AdrianSPratama/SSCS-Chipaton-2025_ChipiChapa/README.md

# SSCS-Chipaton-2025_ChipiChapa
This is ChipiChapa team github repo

## **ChipiChapa Team Project Brief**
Extend OSU's gf180mcu 3v3 standard cell library. Our team makes 4 AOI and OAI combinational gates, that is AOI211, AOI221, OAI211, and OAI221. All of the standard cell we make have 9 tracks and drive strength X1.

## **ChipiChapa Team Members**
1. Rafi Ihsan Alfathin (Leader)
2. Adrian Sami Pratama
3. Muhammad Nabil Raihan
4. Saputra Yudika Marpaung

## **Proposal Slide Link**
https://github.com/AdrianSPratama/SSCS-Chipaton-2025_ChipiChapa/blob/main/proposal/Proposal%20ChipiChapa.pdf

## **Process Tracker Link**
https://docs.google.com/spreadsheets/d/1PtmuyiHweRWKpOBbN-9DdKNZ7erSgrVJdXXUhSANtq4/edit?usp=sharing

## **Schematic/Simulation Review Slide Link**
https://github.com/AdrianSPratama/SSCS-Chipaton-2025_ChipiChapa/blob/main/docs/Schematic%20%26%20Simulation%20Review_ChipiChapa.pdf

## **Pin Out & Estimated Size Slide Link**
https://github.com/AdrianSPratama/SSCS-Chipaton-2025_ChipiChapa/blob/main/docs/Pin%20Out%20%26%20Estimated%20Size_ChipiChapa.pdf

## **ChipiChapa Github Repo**
https://github.com/AdrianSPratama/SSCS-Chipaton-2025_ChipiChapa

## **ChipiChapa Closing Slide**
https://drive.google.com/file/d/1TsjNp-oyjTHYDurA27sHm9y-M0dA2QlG/view?usp=sharing
