AdrianSPratama/SSCS-Chipaton-2025_ChipiChapa/docs/Schematic & Simulation Review_ChipiChapa.pdf

# Schematic/Pre Layout Simulation Review

# ChipiChapa Team

# ChipiChapa Overview

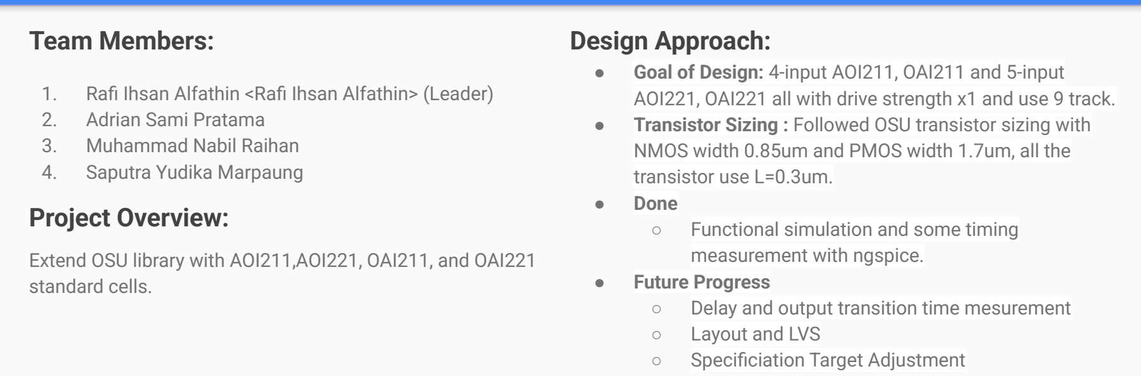
[picture p1: figure]
2. Adrian Sami Pratama 3. Muhammad Nabil Raihan 4. Saputra Yudika Marpaung; Team Members:; Project Overview:; standard cells.; Design Approach:; transistor use L=0.3um. ● Done ○ Functional simulation and some timing measurement with ngspice. ● Future Progress; ○ Layout and LVS ○ Specificiation Target Adjustment

### 1. Rafi Ihsan Alfathin <Rafi Ihsan Alfathin> (Leader)

### Extend OSU library with AOI211,AOI221, OAI211, and OAI221

### - Goal of Design: 4-input AOI211, OAI211 and 5-input

AOI221, OAI221 all with drive strength x1 and use 9 track.

### - Transistor Sizing : Followed OSU transistor sizing with NMOS width 0.85um and PMOS width 1.7um, all the

### - Delay and output transition time mesurement

# Schematic & Functional Simulation

## Schematic

## Symbol

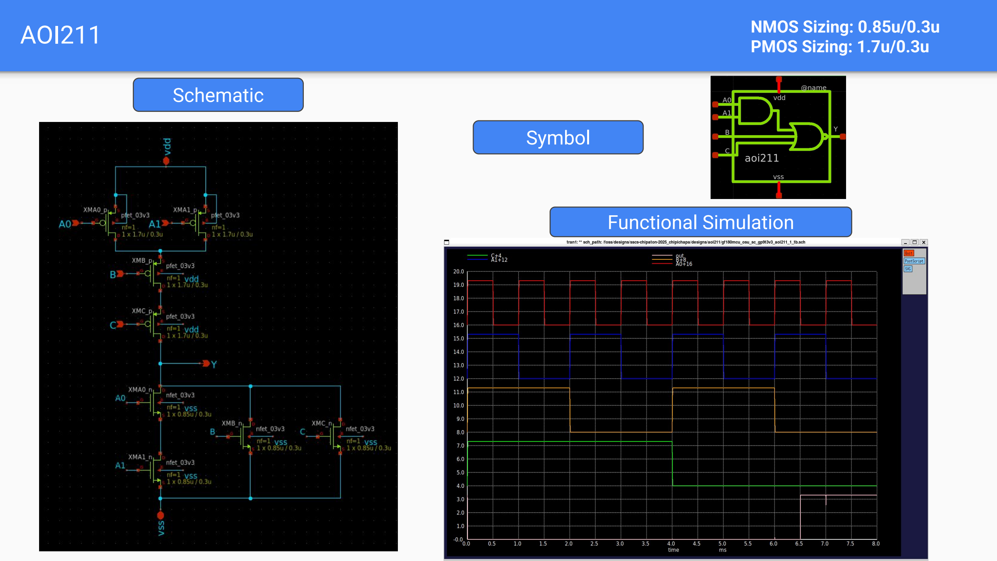
[picture p2: page 4]

AOI211 | NMOS Sizing: 0.85u/0.3u PMOS Sizing: 1.7u/0.3u

## Functional Simulation

## Schematic

## Symbol

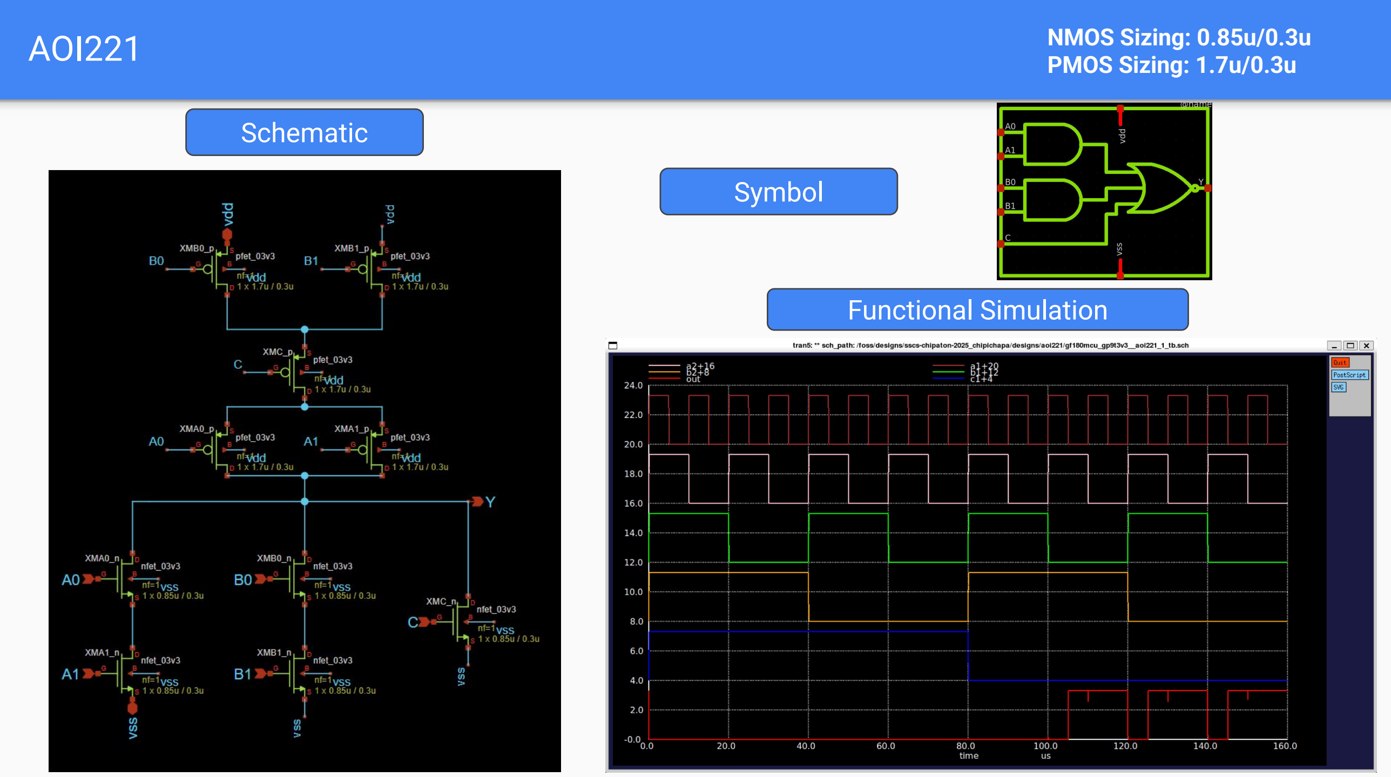
[picture p3: page 5]

AOI221 | NMOS Sizing: 0.85u/0.3u PMOS Sizing: 1.7u/0.3u

## Functional Simulation

## Schematic

## Symbol

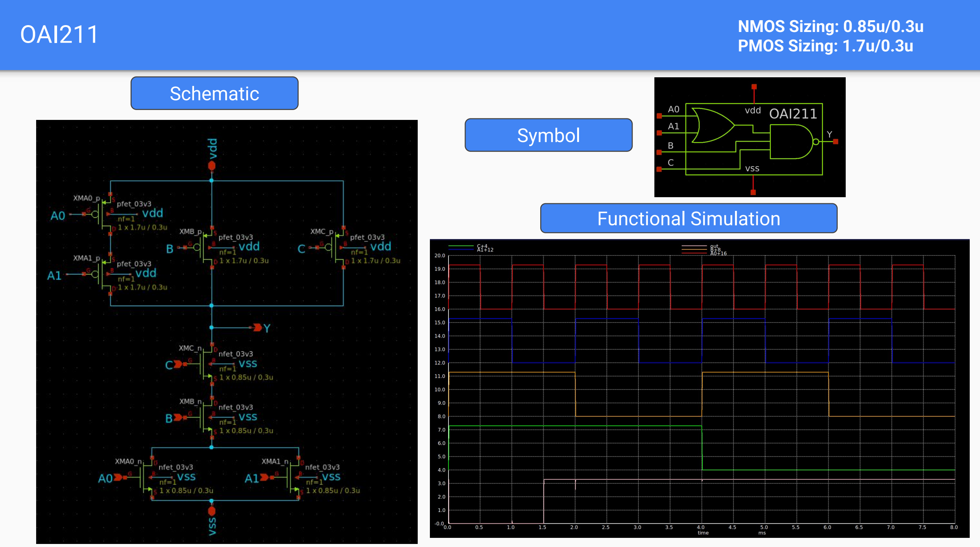
[picture p4: page 6]

OAI211 | NMOS Sizing: 0.85u/0.3u PMOS Sizing: 1.7u/0.3u

## Functional Simulation

## Schematic

## Symbol

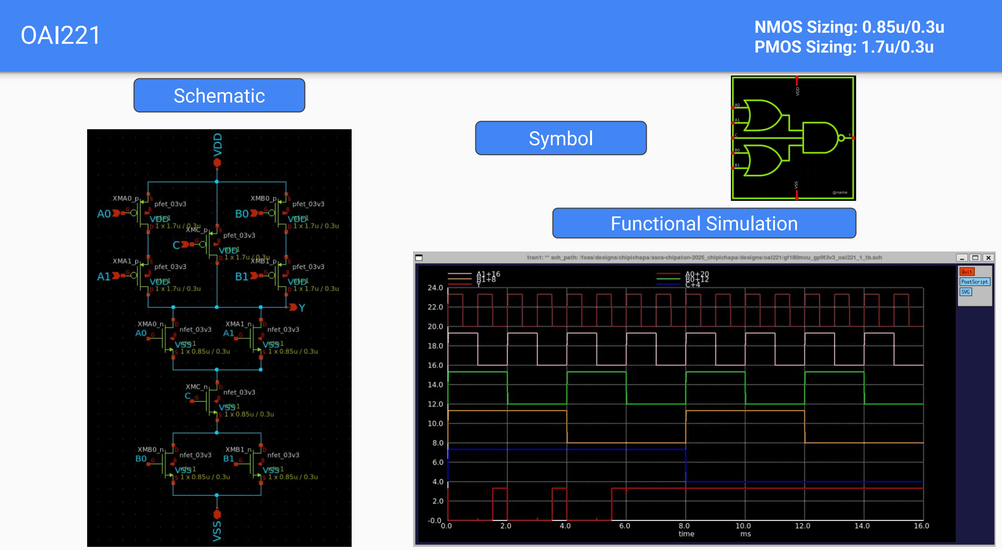
[picture p5: page 7]

OAI221 | NMOS Sizing: 0.85u/0.3u PMOS Sizing: 1.7u/0.3u

## Functional Simulation

# Timing Characterization

# Slews and Load Variations

Slews | 0.0778447 | 0.205581 | 0.542922 | 1.43381 | 3.78657 | 10
Loads | 0.00103698 | 0.00390104 | 0.0146754 | 0.0552075 | 0.207686 | 0.781296

# Note : Only values that correspond to min. slew time and min. output load are

shown in this presentation.

## For AOI211 and AOI221 (followed OSU’s liberty files slew rate and output load for AOI21)

## For OAI211 and OAI221 (followed OSU’s liberty files slew rate and output load for OAI21)

Slews | 0.0778447 | 0.205581 | 0.542922 | 1.43381 | 3.78657 | 10
Loads | 0.00103698 | 0.00389877 | 0.0146583 | 0.0551109 | 0.207201 | 0.779018

# AOI211

Input Pin | Output | Tin (ns) | Out Load (pf) | Delay (ns) | Tout (ns)
A0 (HL) | Y (LH) | 0.0778447 | 0.00103698 | 0.162159 | 0.124471
A0 (LH) | Y (HL) | 0.0778447 | 0.00103698 | 0.091997 | 0.113079
A1 (HL) | Y (LH) | 0.0778447 | 0.00103698 | 0.195498 | 0.161144
A1 (LH) | Y (HL) | 0.0778447 | 0.00103698 | 0.101589 | 0.113557
B (HL) | Y (LH) | 0.0778447 | 0.00103698 | 0.163017 | 0.160679
B (LH) | Y (HL) | 0.0778447 | 0.00103698 | 0.053543 | 0.046408
C (HL) | Y (LH) | 0.0778447 | 0.00103698 | 0.107839 | 0.153007
C (LH) | Y (HL) | 0.0778447 | 0.00103698 | 0.040542 | 0.030509
Pin | Type | Capacitance (pf)
A0 | input | 0.003278
A1 | input | 0.003335
B | input | 0.003200
C | input | 0.003281
Timing Characteristic (Worst Case) | Pin Capacitance

# AOI221

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

Logic
Combination

Leakage Power (nW)

!C!B1!B0!A1!A0 | 0.0233794
!C!B1!B0!A1A0 | 0.0497661
!C!B1!B0A1!A0 | 0.0338073
!C!B1!B0A1A0 | 0.0338025
!C!B1B0!A1!A0 | 0.0233706
!C!B1B0!A1A0 | 0.0497602
!C!B1B0A1!A0 | 0.0338014
!C!B1B0A1A0 | 0.0337944

Average Leakage
Power | 0.0436594

# Thanks!

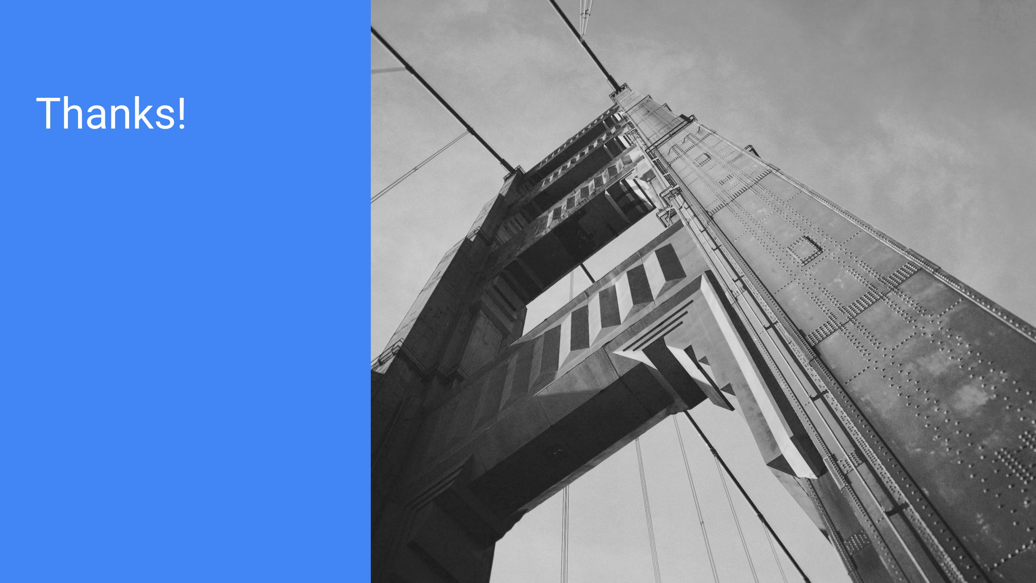
[picture p6: page 19]
