AdrianSPratama/SSCS-Chipaton-2025_ChipiChapa/proposal/Proposal ChipiChapa.pdf

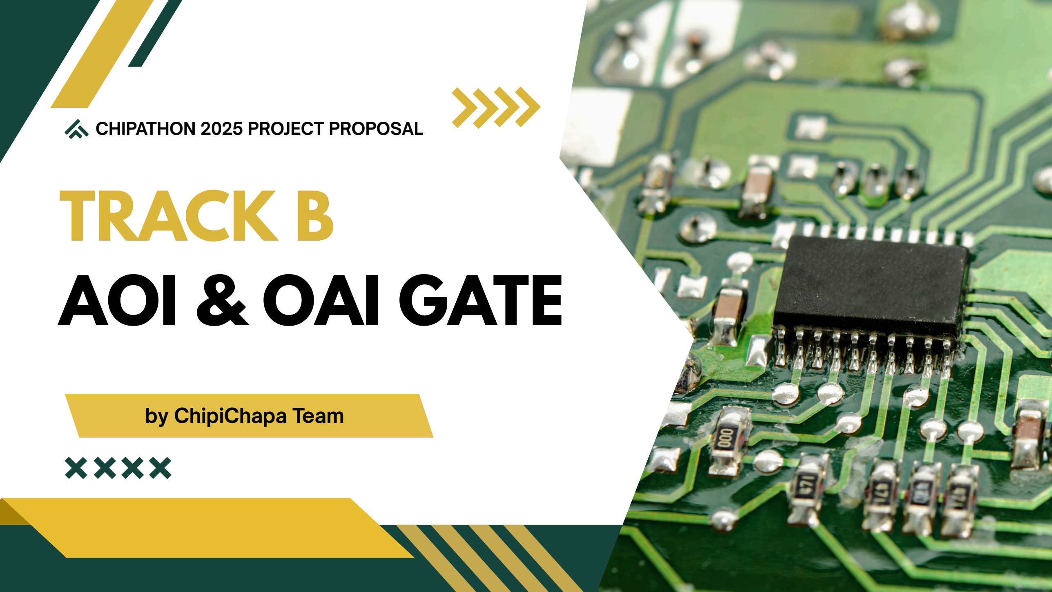
[picture p7: figure]
TRACK B AOI & OAI GATE; by ChipiChapa Team; CHIPATHON 2025 PROJECT PROPOSAL

# Background

In this chipaton, our team will make 4 standard cells library, that is AOI211, OAI211, AOI221, and OAI221.

# We make these AOI dan OAI cells for fundamental cell of further macro cells

like arithmatic cells and multiplexer.

# For the reference of performaces (delay, power, etc), we use performance from standard cells gf180mcu with 5v VDD, and make some goal prediction from those 5v standard cells (tweaking the delay time, power, etc from 5v

and predict how it works for 3v3).

# Functionality

# AOI211

In this chipaton, our team will make 4 standard cells library, that is AOI211, OAI211, AOI31, and OAI221.

# AOI211 is a standard cells with 4 input that has boolean expression:

# Y = !((A1 & A2) | B1 | C1)

# AOI221

# AOI221 is a standard cells with 5 input that has boolean expression:

# Y = !((A1 & A2) | (B1 & B2) | C1)

# OAI211

# OAI211 is a standard cells with 4 input that has boolean expression:

# Y = !((A1 | A2) & B1 & C1))

# OAI221

# OAI221 is a standard cells with 5 input that has boolean expression:

# Y = !((A1 | A2) & (B1 | B2) & C1)

LIBRARY | gf180mcu_osu_sc_9t3v3

CELLS

1. AOI 211 :
gf180mcu_osu_sc_gp9t3v3__aoi211_1 (https://github.com/stineje/globalfoundries-pdk-libs-gf180mcu_osu_sc/blob/main/gf180mcu_osu_sc_gp9t3v3/cells/aoi22/gf180mcu_osu_sc_gp9t3v3__aoi22_1.gds)
2. OAI211:
gf180mcu_osu_sc_gp9t3v3__oai211_1 (https://github.com/stineje/globalfoundries-pdk-libs-gf180mcu_osu_sc/blob/main/gf180mcu_osu_sc_gp9t3v3/cells/aoi22/gf180mcu_osu_sc_gp9t3v3__aoi22_1.gds) 3.AOI221:
gf180mcu_osu_sc_gp9t3v3__aoi221_1 (https://github.com/stineje/globalfoundries-pdk-libs-gf180mcu_osu_sc/blob/main/gf180mcu_osu_sc_gp9t3v3/cells/aoi22/gf180mcu_osu_sc_gp9t3v3__aoi22_1.gds) 4.OAI221:
gf180mcu_osu_sc_gp9t3v3__oai221_1 (https://github.com/stineje/globalfoundries-pdk-libs-gf180mcu_osu_sc/blob/main/gf180mcu_osu_sc_gp9t3v3/cells/aoi22/gf180mcu_osu_sc_gp9t3v3__aoi22_1.gds)
DRIVE STRENGTH | 1X
TRACK | 9 Track
VDD | 3.3V

# General Format & Specification

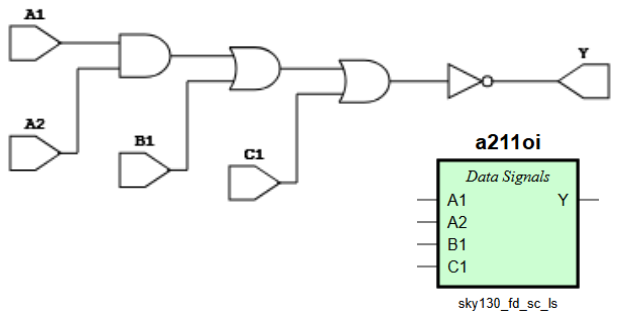
[picture p8: figure]

Specification | Target
Input Capacitance | <0.01 pF
Delay | <0.40 ns
Output Load | 0.001 pF

# Gate Level

# Block Diagram & Schematic - AOI211

Specification | Target

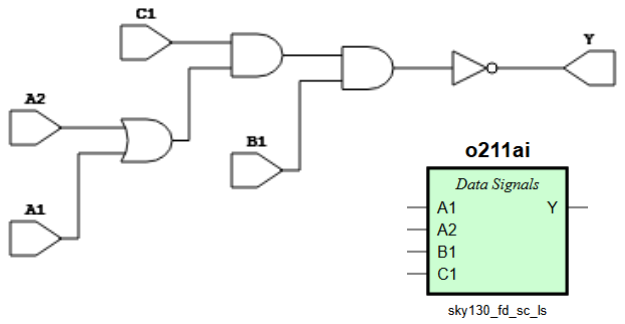
[picture p9: figure]

Input Capacitance | <0.01 pF
Delay | <0.40 ns
Output Load | 0.001 pF

# Gate Level

# Block Diagram & Schematic - OAI211

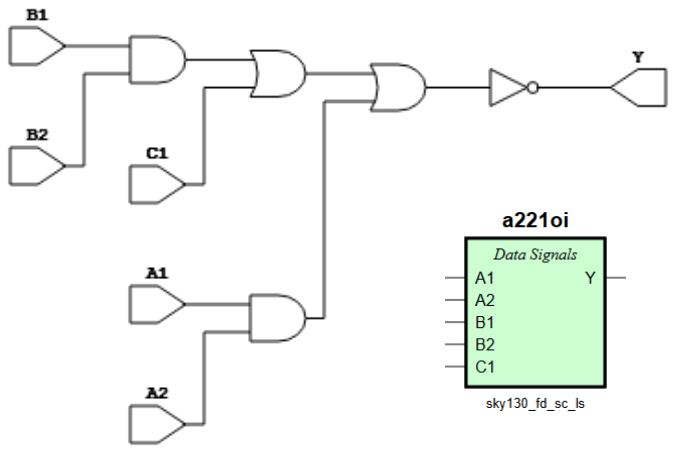
[picture p10: figure]

Specification | Target
Input Capacitance | <0.01 pF
Delay | <0.90ns
Output Load | 0.001 pF

# Gate Level

# Block Diagram & Schematic - AOI221

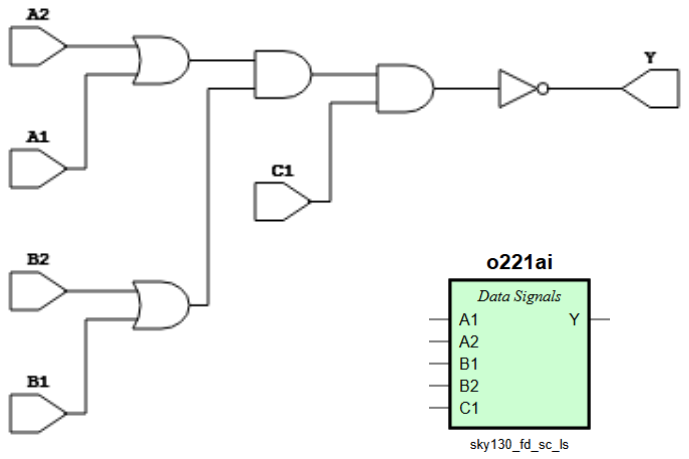
[picture p11: figure]

Specification | Target
Input Capacitance | <0.01 pF
Delay | <0.90ns
Output Load | 0.001 pF

# Block Diagram & Schematic - OAI221

# Gate Level

Member Name | Rafi Ihsan Alfathin | Saputra Yudika Marpaung | Adrian Sami Pratama | Muhammad Nabil Raihan
Block will be working on | AOI211 | OAI211 | AOI221 | OAI221

Task Detail

1.Design schematic
with XSchem
2.Simulation with
ngspice
3.Layouting, DRC, and
LVS with
Klayout/Magic
4.Generate parasitic
RC with Magic
5.Characterizing the
cell with
Charlib/Libretto

1.Design schematic
with XSchem
2.Simulation with
ngspice
3.Layouting, DRC, and
LVS with
Klayout/Magic
4.Generate parasitic
RC with Magic
5.Characterizing the
cell with
Charlib/Libretto

1.Design schematic
with XSchem
2.Simulation with
ngspice
3.Layouting, DRC, and
LVS with
Klayout/Magic
4.Generate parasitic
RC with Magic
5.Characterizing the
cell with
Charlib/Libretto

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

# Task Distribution

# Our Team Task

| Chipathon’s Plan (Week)
Team Formation and Project Planning | Design and Simulation | Layout and Verification
28 | 29 | 30 | 31 | 32 | 33 | 34 | 35 | 36 | 37 | 38 | 39 | 40

Design schematic with XSchem

Simulation with ngspice

Layouting, DRC, and LVS with Klayout/Magic

Generate parasitic RC with Magic

Characterizing the cell with Charlib/Libretto, revision, and finalization

# Project Timeline

# THANK YOU

### link to our github : ChipiChapa Github Repo Link: https://github.com/AdrianSPratama/SSCS-Chipaton-2025_ChipiChapa?tab=readme-ov-file

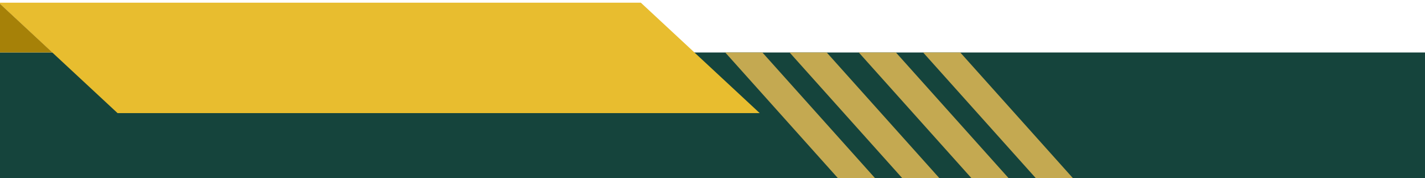
[picture p12: figure]
