AdrianSPratama/SSCS-Chipaton-2025_ChipiChapa/designs/aoi221/gf180mcu_gp9t3v3__aoi221_1_schematic.png

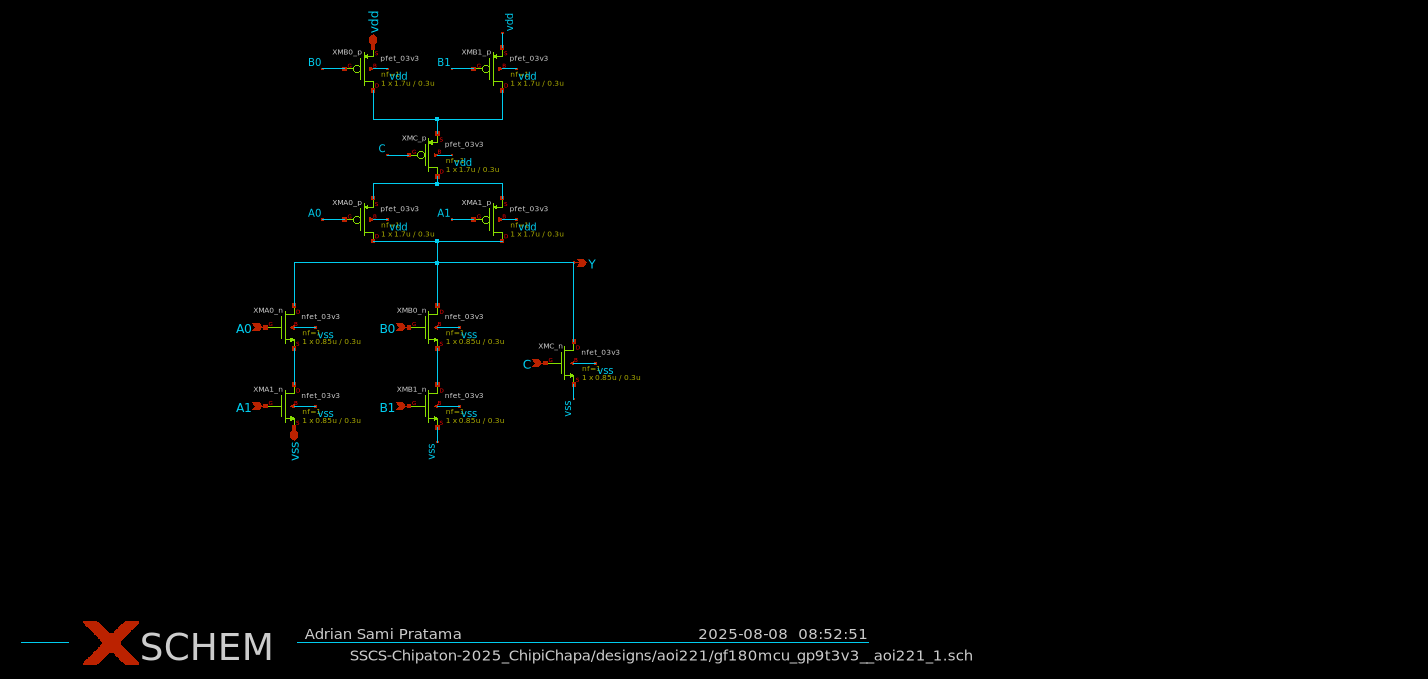
designs/aoi221/gf180mcu_gp9t3v3__aoi221_1_schematic.png
