AdrianSPratama/SSCS-Chipaton-2025_ChipiChapa/designs/aoi211/gf180mcu_osu_sc_gp9t3v3_aoi211_1_lvs.spice

* NGSPICE file created from gf180mcu_osu_sc_gp9t3v3_aoi211_1.ext - technology: gf180mcuD

.subckt gf180mcu_osu_sc_gp9t3v3_aoi211_1 vdd A0 A1 B C Y vss
X0 a_70_30# A1 vss vss nfet_03v3 ad=0.23375p pd=1.4u as=0.425p ps=2.7u w=0.85u l=0.3u
X1 vdd A1 a_n90_540# vdd pfet_03v3 ad=0.4675p pd=2.25u as=0.85p ps=4.4u w=1.7u l=0.3u
X2 Y C a_410_540# vdd pfet_03v3 ad=0.85p pd=4.4u as=0.2125p ps=1.95u w=1.7u l=0.3u
X3 Y C vss vss nfet_03v3 ad=0.425p pd=2.7u as=0.23375p ps=1.4u w=0.85u l=0.3u
X4 a_n90_540# A0 vdd vdd pfet_03v3 ad=0.4675p pd=2.25u as=0.4675p ps=2.25u w=1.7u l=0.3u
X5 vss B Y vss nfet_03v3 ad=0.23375p pd=1.4u as=0.23375p ps=1.4u w=0.85u l=0.3u
X6 Y A0 a_70_30# vss nfet_03v3 ad=0.23375p pd=1.4u as=0.23375p ps=1.4u w=0.85u l=0.3u
X7 a_410_540# B a_n90_540# vdd pfet_03v3 ad=0.2125p pd=1.95u as=0.4675p ps=2.25u w=1.7u l=0.3u
.ends
