AdrianSPratama/SSCS-Chipaton-2025_ChipiChapa/designs/oai211/layoutrefinement/gf180mcu_gp9t3v3_oai211_1.yml

settings:
    lib_name:           gf180mcu_gp9t3v3_oai211_1_postlayout_PEX
    omit_on_failure:      True
    units:
        time:               ns
        voltage:            V
        current:            uA
        pulling_resistance: kOhm
        leakage_power:      nW
        capacitive_load:    pF
        energy:             fJ
    named_nodes:
        vdd:
            name:       VDD
            voltage:    3.3
        vss:
            name:       VSS
            voltage:    0
        pwell:
            name:       VPW
            voltage:    0
        nwell:
            name:       VNW
            voltage:    3.3
    cell_defaults:
        simulation_timestep: 0.0175
        models:
            # This syntax tells CharLib to use the '.lib file section' syntax for th>
            - /foss/designs/models/sm141064.ngspice typical
            - /foss/designs/models/design.ngspice
        slews:  [0.0778447, 0.205581, 0.542922, 1.43381, 3.78657, 10]
        loads:  [0.00103698, 0.00389877, 0.0146583, 0.0551109, 0.207201, 0.779018]
cells:
    gf180mcu_gp9t3v3_oai211_1:
        netlist:  /foss/designs/SSCS-Chipaton-2025_ChipiChapa/designs/oai211/layoutrefinement/gf180mcu_gp9t3v3_oai211_1_layoutwithcap&res.spice
        inputs:     [A0, A1, B, C]
        outputs:    ['Y']
        functions: [Y=!((A0|A1) & B & C)]
