AdrianSPratama/SSCS-Chipaton-2025_ChipiChapa/(commit log)

2025-07-10 update proposal schematics image and symbol
2025-07-15 feat aoi221 schematics and testbench
    [gf180mcu_gp9t3v3__aoi221_1.sch, gf180mcu_gp9t3v3__aoi221_1_tb.sch]
2025-07-21 Feat test
    First test
    [gf180mcu_gp9t3v3__aoi221_1.sch]
2025-07-22 update schematic, pmos and nmos sizing
    [gf180mcu_gp9t3v3__aoi221_1.sch]
2025-07-31 refactor mosfet namings and change W/L
    [gf180mcu_gp9t3v3__aoi221_1.sch]
2025-08-01 feat oai211 schematic and test bench
    [gf180mcu_gp9t3v3_oai211_1.sch, gf180mcu_gp9t3v3_oai211_1_tb.sch]
2025-08-01 Feat add sch, tb, raw, and sym files
    Adding aoi211 schematic
    Adding aoi211 testbench
    Adding aoi211 symbols
    Adding aoi211 spice raw
    Adding temporary files store_simulasi_cadangan
    Removing aoi221 schematic
    [gf180mcu_gp9t3v3__aoi221_1.sch, gf180mcu_osu_sc_gp9t3v3_aoi211_1.sch, gf180mcu_osu_sc_gp9t3v3_aoi211_1_tb.sch]
2025-08-01 Feat added new symbol image
    Updated the symbol for aoi211
    [gf180mcu_osu_sc_gp9t3v3_aoi211_1_tb.sch]
2025-08-01 feat schematic image
2025-08-01 update testbench, add a capacitor to the output
    [gf180mcu_gp9t3v3__aoi221_1_tb.sch]
2025-08-01 Add: oai221 folder
    [gf180mcu_gp9t3v3_oai221_1.sch, gf180mcu_gp9t3v3_oai221_1_tb.sch]
2025-08-01 feat testbench, measuring parameters
    Measure tplh, tphl, rise, fall times in 1MHz
    [gf180mcu_gp9t3v3__aoi221_1_tb.sch]
2025-08-01 Feat add tb2
    [gf180mcu_osu_sc_gp9t3v3_aoi211_1_tb.sch]
2025-08-01 refactor schematic image file name
2025-08-01 feat timing simulation and update symbol
    [gf180mcu_gp9t3v3_oai211_1_tb.sch, gf180mcu_gp9t3v3_oai211_1_tb2.sch]
2025-08-01 Feat testbench update
    update testbench with tphl, tplh, and rise & fall times
    [gf180mcu_osu_sc_gp9t3v3_aoi211_1_tb.sch]
2025-08-01 feat update simulation
    [gf180mcu_gp9t3v3_oai211_1_tb.sch, gf180mcu_gp9t3v3_oai211_1_tb2.sch]
2025-08-05 feat dynamic power and leakage power simulation
    [gf180mcu_gp9t3v3__aoi221_1_tb.sch]
2025-08-05 Feat add testbench for power
    Added testbench for power, now its only leakage power of all possible input.
    [gf180mcu_osu_sc_gp9t3v3_aoi211_1_tb_power.sch]
2025-08-06 Feat add .op simulation for power
    [gf180mcu_osu_gp9t3v3_aoi211_1_tb_powerwithdcop.sch]
2025-08-06 Feat add avg power in tb
    [gf180mcu_osu_gp9t3v3_aoi211_1_tb_powerwithdcop.sch]
2025-08-07 update power simulation
    [gf180mcu_gp9t3v3_oai211_1_tb.sch, gf180mcu_gp9t3v3_oai211_1_tb2.sch, gf180mcu_gp9t3v3_oai211_1_tb_power.sch]
2025-08-07 update dikit
    [gf180mcu_gp9t3v3_oai211_1_tb_power.sch]
2025-08-07 Feat fixing some files
    [gf180mcu_osu_gp9t3v3_aoi211_1_tb_powerwithdcop.sch, gf180mcu_osu_sc_9p9t3v3_aoi211_1_tb_2.sch, gf180mcu_osu_sc_gp9t3v3_aoi211_1_tb.sch]
2025-08-07 feat detailed power leakage simulation
    [gf180mcu_gp9t3v3__aoi221_1_tb_power_with_dc_op.sch]
2025-08-07 Feat fixing tb
    [gf180mcu_osu_gp9t3v3_aoi211_1_tb_powerwithdcop.sch]
2025-08-08 refactor changed the alternative layout
    Changed the alternative layout into the main
    [gf180mcu_gp9t3v3__aoi221_1.sch]
2025-08-08 update schematic
    Change the order of the series pmos in the schematic
    [gf180mcu_gp9t3v3__aoi221_1.sch]
2025-08-08 update power leakage simulations
    [gf180mcu_gp9t3v3__aoi221_1_tb_power_with_dc_op.sch]
2025-08-08 update power leakage simulation
    [gf180mcu_gp9t3v3__aoi221_1_tb_power_with_dc_op.sch]
2025-08-10 update schematic image svg
2025-08-10 update image for schematic and symbol png image
2025-08-11 update yaml file capacitance and slew rate tests
2025-08-12 Feat add YAML and liberty file + reorganizing
    [gf180mcu_osu_gp9t3v3_aoi211_1_tb_powerwithdcop.sch, gf180mcu_osu_sc_9p9t3v3_aoi211_1_tb_2.sch, gf180mcu_osu_sc_gp9t3v3_aoi211_1_tb.sch, gf180mcu_osu_sc_gp9t3v3_aoi211_1_tb_power.sch]
2025-08-12 feat update characterization
    [gf180mcu_gp9t3v3_oai211_1_tb_power.sch]
2025-08-13 Feat: fix aja lah
    [gf180mcu_gp9t3v3_oai221_1.sch, gf180mcu_gp9t3v3_oai221_1_tb.sch, gf180mcu_gp9t3v3_oai221_1_tb_power.sch]
2025-08-13 Feat: fix aja lah yang kedua
    [gf180mcu_gp9t3v3_oai221_1_tb.sch]
2025-08-14 Feat add power and delay simulations
    [gf180mcu_gp9t3v3_oai221_1.sch, gf180mcu_gp9t3v3_oai221_1_tb.sch]
2025-08-14 Feat add power and delay simulation
2025-08-15 Pin Out and Estimated Size V2
2025-08-21 feat update gds, lef, and others
    [gf180mcu_gp9t3v3_oai211_1_tb.sch, gf180mcu_gp9t3v3_oai211_1_tb2.sch, gf180mcu_gp9t3v3_oai211_1_tb_power.sch]
2025-08-27 Fix lvs and pex simulation for oai221
    [gf180mcu_gp9t3v3_oai221_1.sch]
2025-09-23 feat fix one tieh tiel & set one d bi pin
2025-09-26 feat insert all cell, connect power
2025-09-30 fix power routing
2025-09-30 fix antenna drc in tieh tiel cells
2025-10-03 fix antenna on qft
2025-10-16 fix antenna and metal3 offgrid
2025-10-23 fix LVPWELL error (hole in the layer)
